VincentZ751/Drone_FC_project/Other_files/amongus.jpg

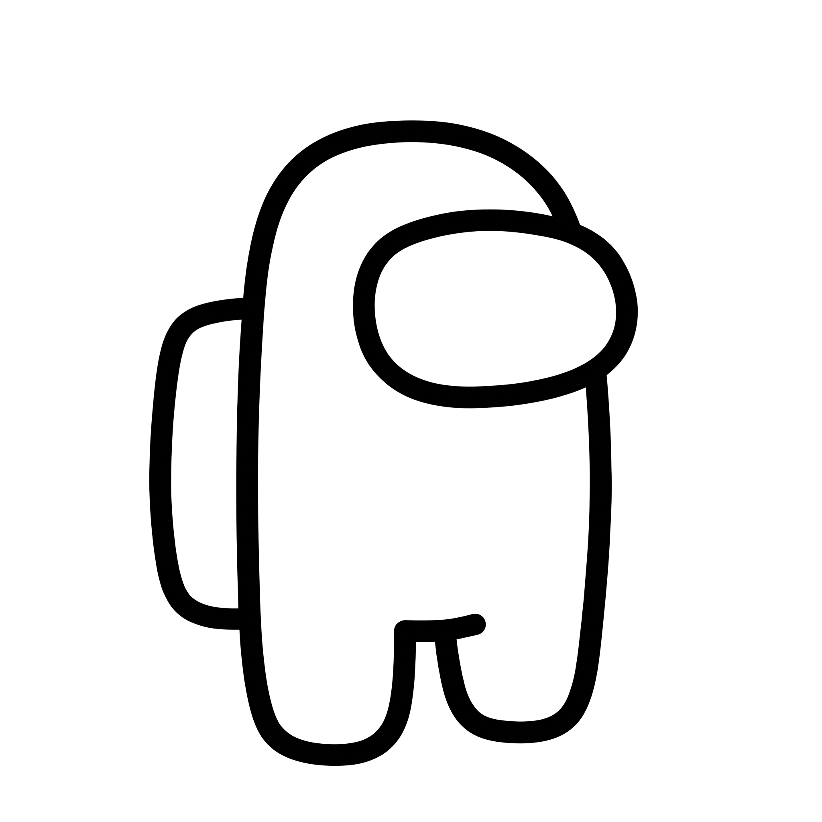
Other_files/amongus.jpg
