VincentZ751/Drone_FC_project/Other_files/finished_PCB.png

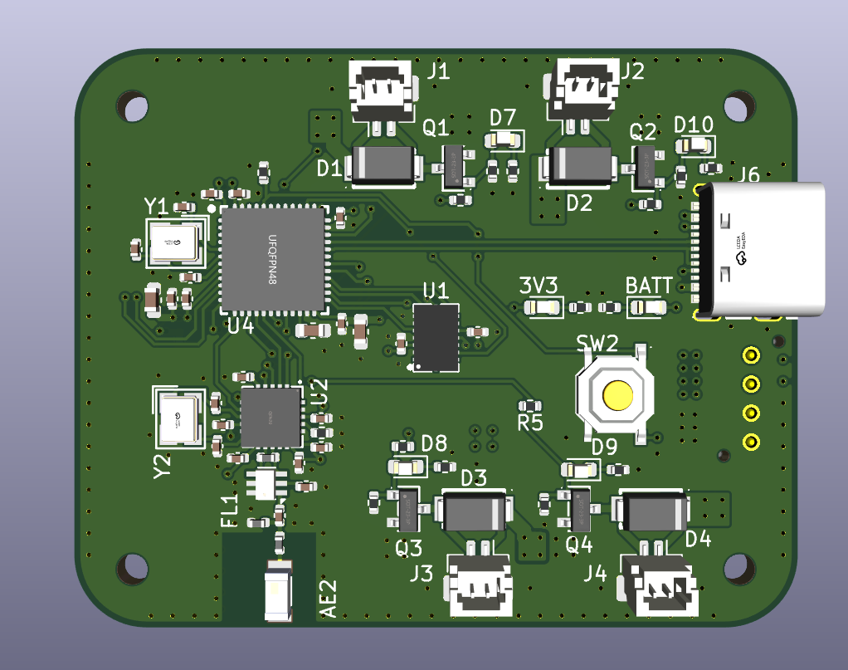
Other_files/finished_PCB.png
