VincentZ751/Drone_FC_project/Other_files/Gemini_Generated_Image_xpuy9sxpuy9sxpuy.jpg

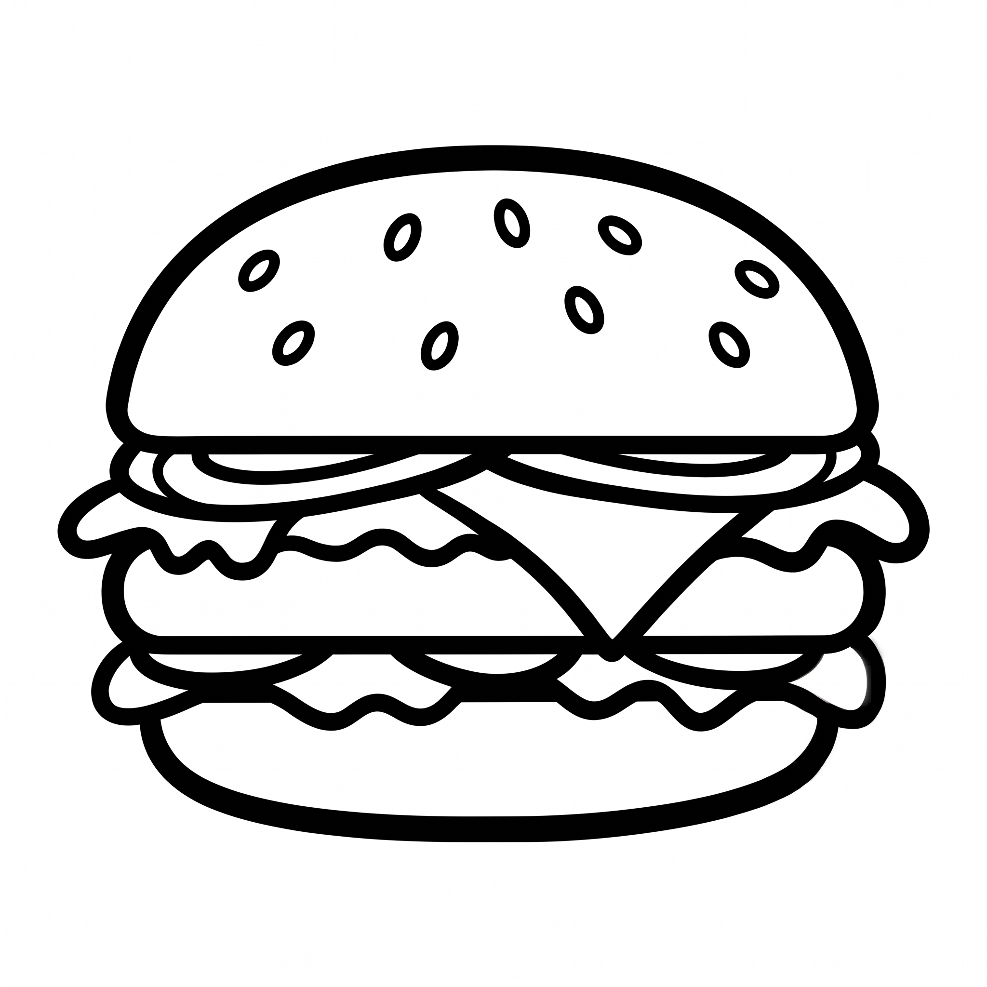
Other_files/Gemini_Generated_Image_xpuy9sxpuy9sxpuy.jpg
