VincentZ751/Drone_FC_project/Other_files/PCB_routing2.png

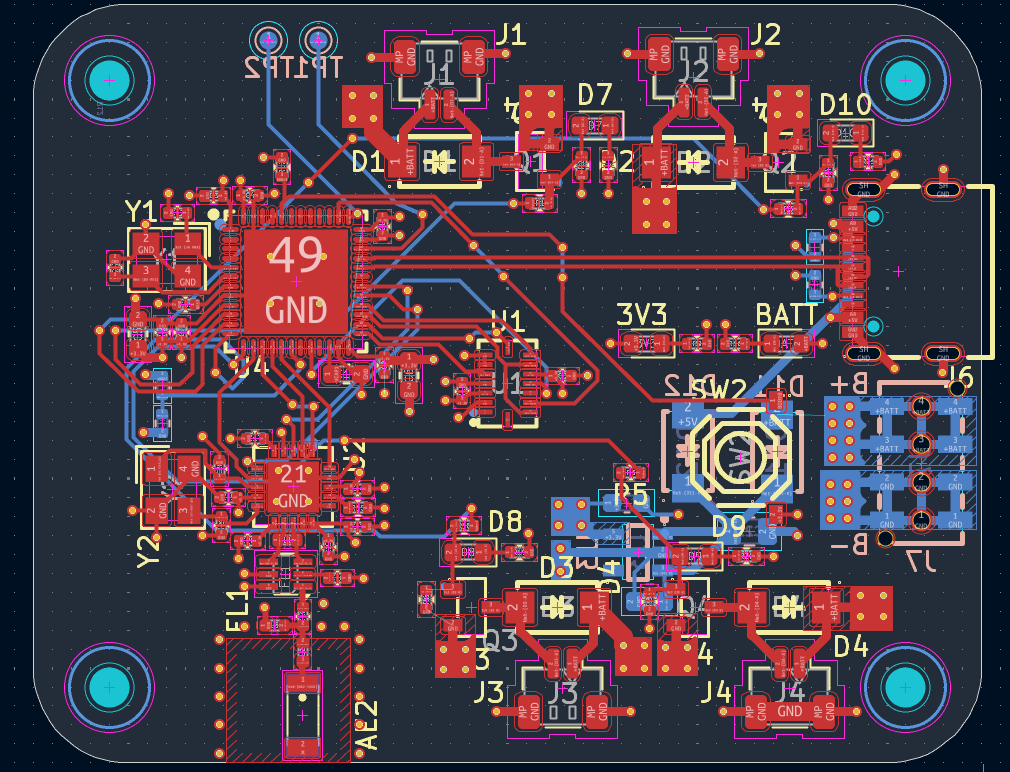
Other_files/PCB_routing2.png
