VincentZ751/Drone_FC_project/Other_files/pre-revert_PCB2.png

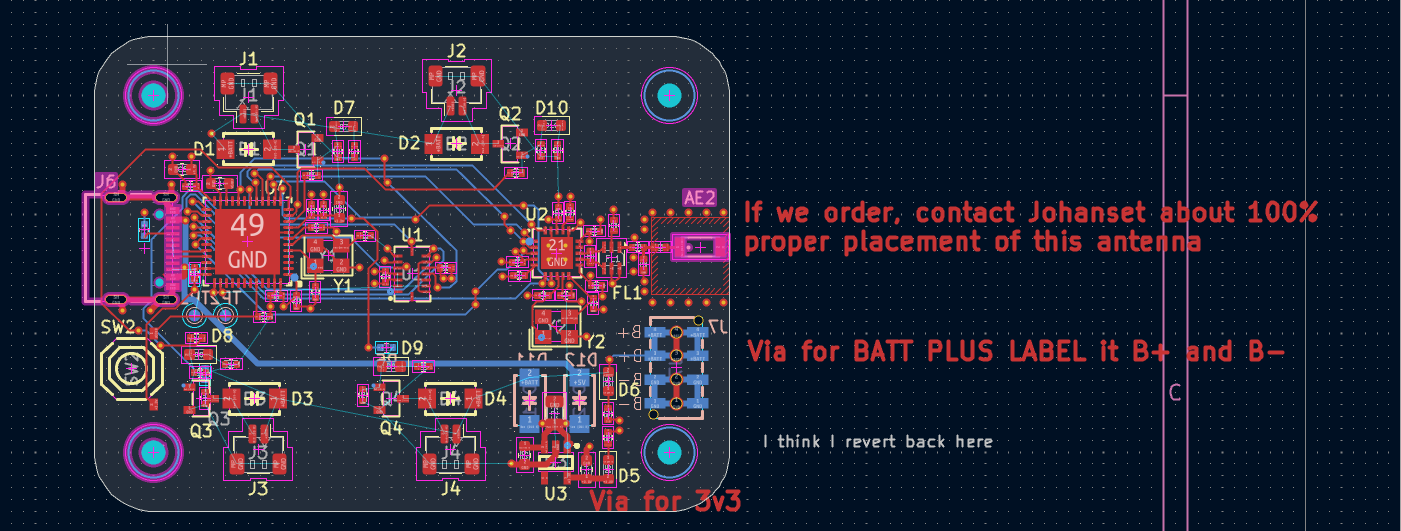
Other_files/pre-revert_PCB2.png
