VincentZ751/Drone_FC_project/Other_files/pre-revert_PCB.png

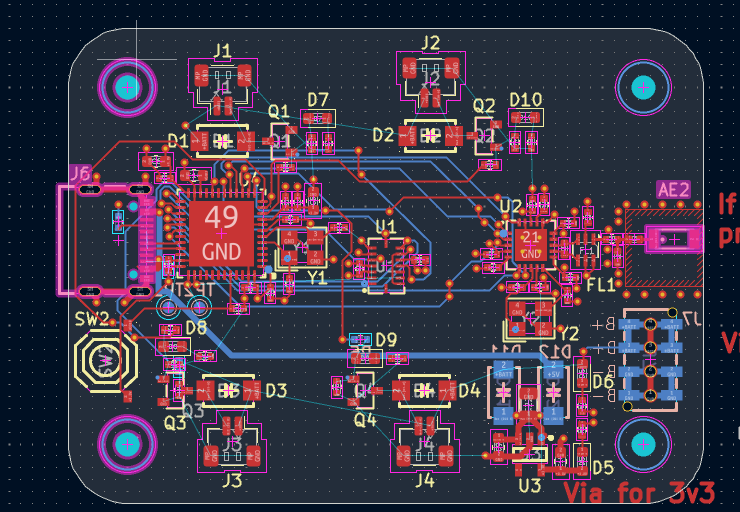
Other_files/pre-revert_PCB.png
