VincentZ751/Drone_FC_project/Other_files/schematic_image1.png

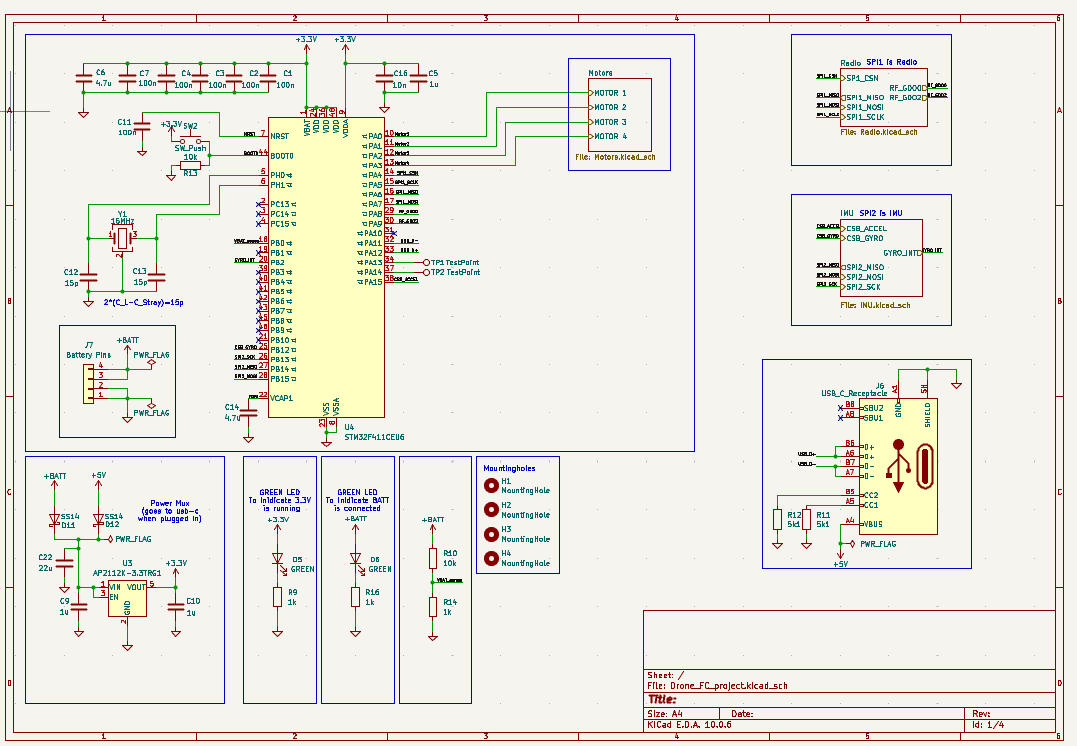
Other_files/schematic_image1.png
