VincentZ751/Drone_FC_project/Other_files/stm32_pinout_image.png

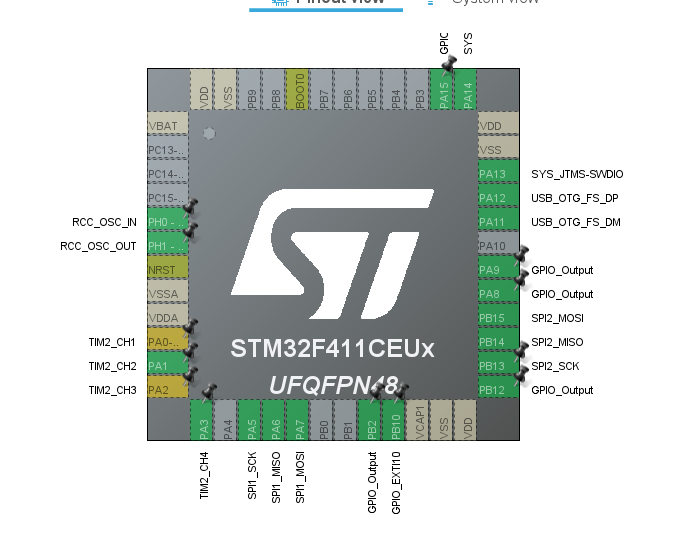
Other_files/stm32_pinout_image.png
