VincentZ751/Drone_FC_project/production/bom.csv

Designator | Footprint | Quantity | Value | LCSC Part #
3V3, BATT | 0603 | 2 | GREEN
AE2 | XDCR_2450AT18B100E | 1 | 2450AT18B100E
C1, C11, C15, C17, C2, C23, C24, C25, C26, C27, C3, C4, C7, C8 | 0402 | 14 | 100n
C10, C5, C9 | 0603 | 3 | 1u
C12, C13 | 0402 | 2 | 15p
C14, C6 | 0603 | 2 | 4.7u
C16, L1 | 0402 | 2 | 10n
C18 | 0402 | 1 | 22p
C19 | 0402 | 1 | 1p2
C20, C21 | 0402 | 2 | 27p
C22 | 0805 | 1 | 22u
D1, D11, D12, D2, D3, D4 | SS14 | 6 | SS14 | C2480
D10, D7, D8, D9 | 0603 | 4 | RED
FL1 | Balun_Johanson_0896BM15A0001 | 1 | 2450BM15B0003001E
J1, J2, J3, J4 | JST_SH_BM02B-SRSS-TB_1x02-1MP_P1.00mm_Vertical | 4 | Conn_01x02_MountingPin
J6 | USB_C_Receptacle_TYPE-C-31-M-12A | 1 | USB_C_Receptacle | C5337088
J7 | Battery_pin | 1 | Battery Pins | C39833032
L2 | 0402 | 1 | 3n3
L3 | 0402 | 1 | 2n7
Q1, Q2, Q3, Q4 | SOT-23-3_AO3400A | 4 | AO3400A | C20917
R1, R18, R3, R5 | 0402 | 4 | 47R
R10, R13, R2, R4, R6, R8 | 0402 | 6 | 10k
R11, R12 | 0402 | 2 | 5k1
R14, R16, R17, R19, R20, R21, R9 | 0402 | 7 | 1k
R15 | 0402 | 1 | 56k
SW2 | TS-1187A-B-A-B(SPST_button) | 1 | SW_Push | C318884
TP1, TP2 | TestPoint_Pad_D1.0mm | 2 | TestPoint
U1 | LGA-16_Bosch_BMI088 | 1 | BMI088 | C194919
U2 | QFN-20_CC2500RGPR | 1 | CC2500RGPR | C57494
U3 | SOT-23-5_AP2112K-3.3 | 1 | AP2112K-3.3TRG1 | C51118
U4 | UFQFPN-48_STM32F411CEU6 | 1 | STM32F411CEU6 | C60420
Y1 | Crystal_SMD_3225-4P(16_26MHz) | 1 | 16MHz | C70573
Y2 | Crystal_SMD_3225-4P(16_26MHz) | 1 | 26MHz | C70573
