VincentZ751/Drone_FC_project/other_parts/2450AT18B100E/2450AT18B100E.step

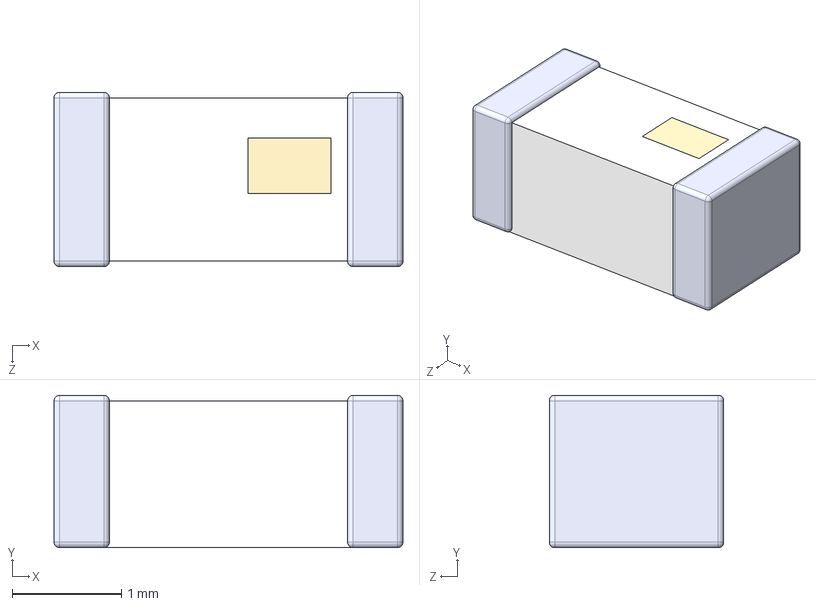
[picture p9: CAD file, 2026-10-24]
other_parts/2450AT18B100E/2450AT18B100E.step
3.20 x 1.40 x 1.60 mm
