VincentZ751/Drone_FC_project/Drone_FC_project.kicad_pcb

## KiCad design Drone_FC_project.kicad_pcb (2026-11-09)

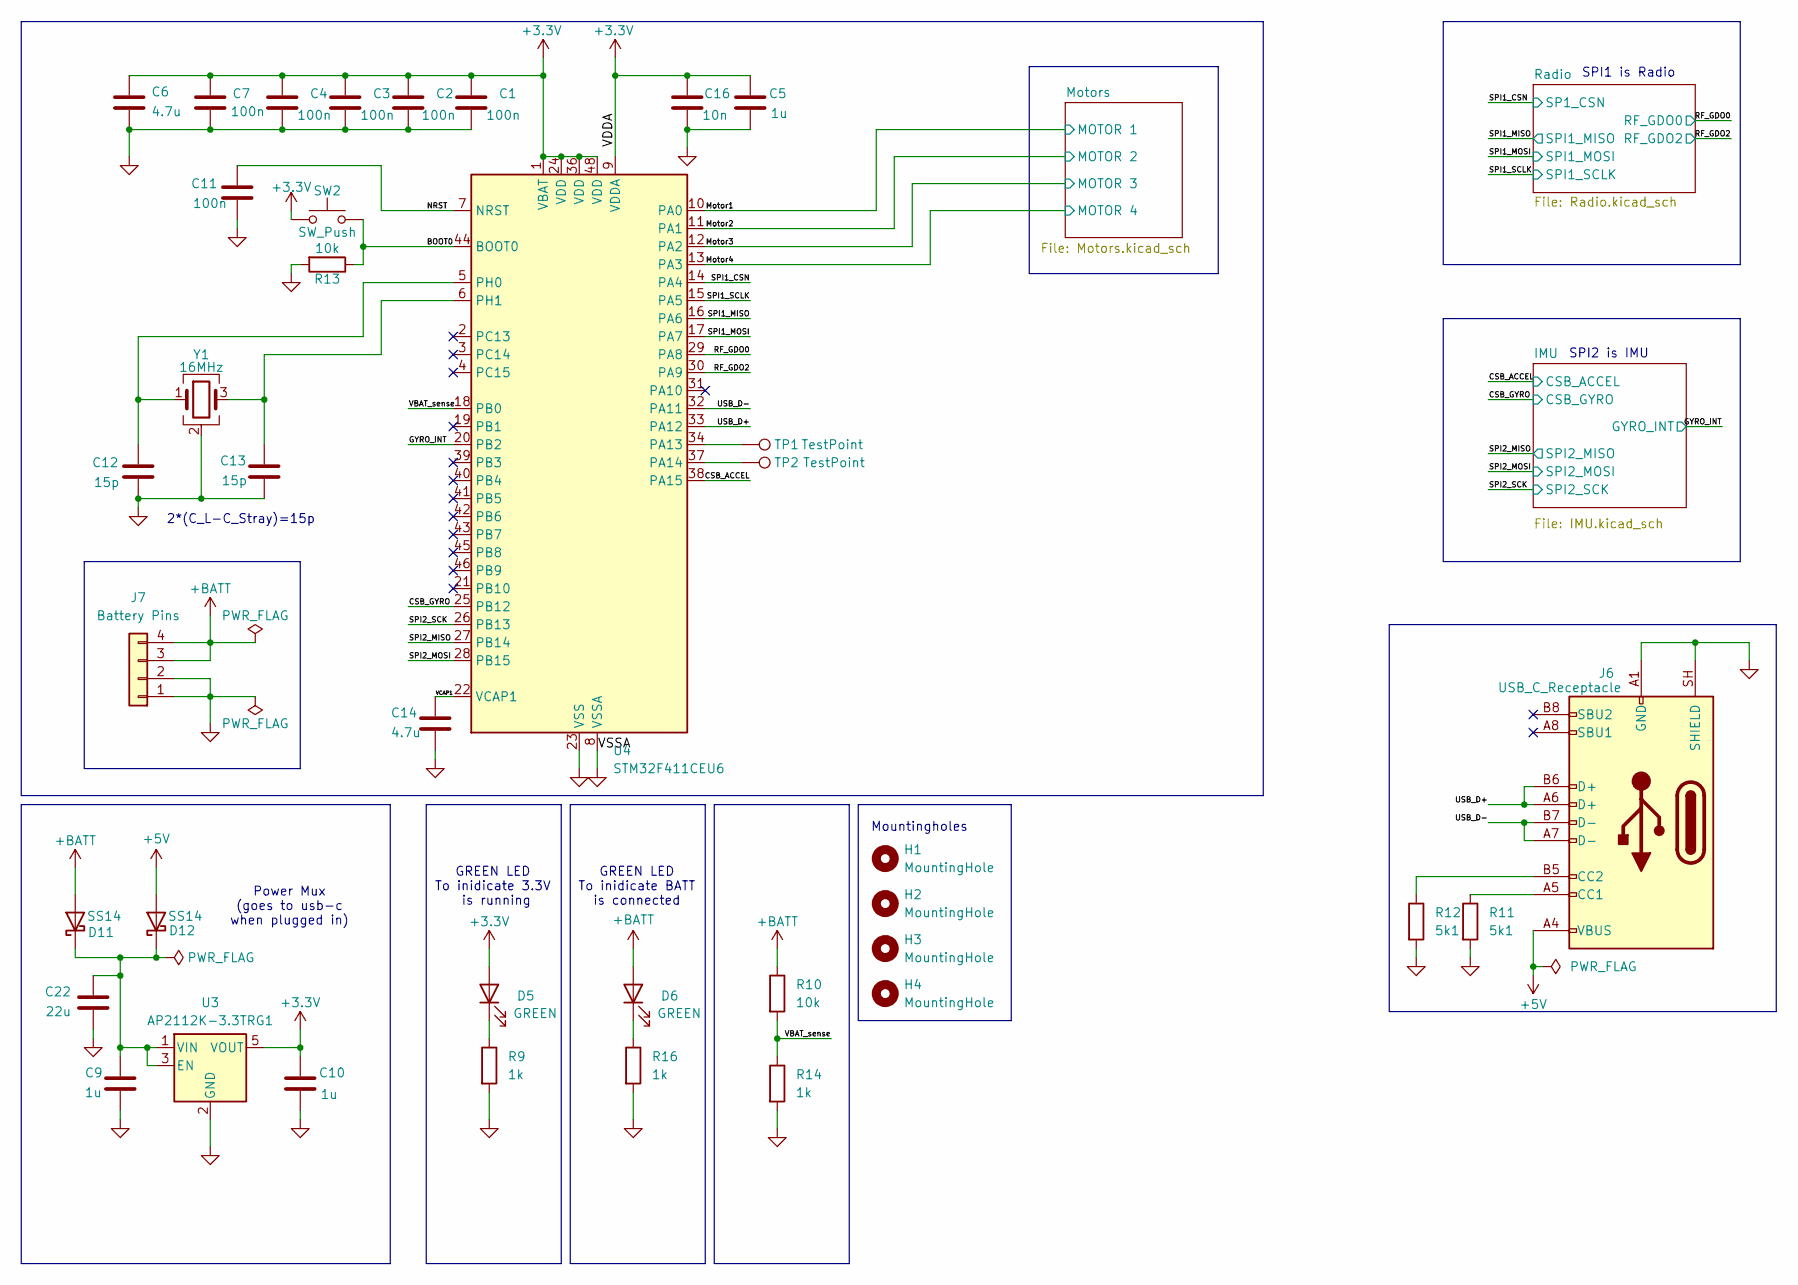
[picture p14: schematic Drone_FC_project.kicad_sch]

Parts:
C1, C2, C3, C4, C7, C11: 100n; C_0402_1005Metric
C5, C9, C10: 1u; C_0603_1608Metric
C6, C14: 4.7u; C_0603_1608Metric
C12, C13: 15p; C_0402_1005Metric
C16: 10n; C_0402_1005Metric
C22: 22u; C_0805_2012Metric
D5, D6: GREEN; LED_0603_1608Metric
D11, D12: SS14
H1, H2, H3, H4: MountingHole; MountingHole_2.1mm
J6: USB_C_Receptacle; USB_C_Receptacle_TYPE-C-31-M-12A
J7: Battery Pins; Battery_pin
R9, R14, R16: 1k; R_0402_1005Metric
R10, R13: 10k; R_0402_1005Metric
R11, R12: 5k1; R_0402_1005Metric
SW2: SW_Push; TS-1187A-B-A-B(SPST_button)
TP1, TP2: TestPoint; TestPoint_Pad_D1.0mm
U3: AP2112K-3.3TRG1; SOT-23-5_AP2112K-3.3
U4: STM32F411CEU6; UFQFPN-48_STM32F411CEU6
Y1: 16MHz; Crystal_SMD_3225-4P(16_26MHz)

Connections:
+3.3V: C1.1, C2.1, C3.1, C4.1, C5.1, C6.1, C7.1, C10.1, C16.1, D5.2 (A), SW2.2, U3.5 (VOUT), U4.1 (VBAT), U4.9 (VDDA), U4.24 (VDD), U4.36 (VDD), U4.48 (VDD); also elsewhere on the board
+5V: D12.2 (A), J6.A4 (VBUS), J6.A9 (VBUS), J6.B4 (VBUS), J6.B9 (VBUS)
+BATT: D6.2 (A), D11.2 (A), J7.3, J7.4, R10.1; also elsewhere on the board
/BOOT0: R13.1, SW2.1, U4.44 (BOOT0)
/CSB_ACCEL: U4.38 (PA15); also elsewhere on the board
/CSB_GYRO: U4.25 (PB12); also elsewhere on the board
/GYRO_INT: U4.20 (PB2); also elsewhere on the board
/Motor1: U4.10 (PA0); also elsewhere on the board
/Motor2: U4.11 (PA1); also elsewhere on the board
/Motor3: U4.12 (PA2); also elsewhere on the board
/Motor4: U4.13 (PA3); also elsewhere on the board
/NRST: C11.1, U4.7 (NRST)
/RF_GDO0: U4.29 (PA8); also elsewhere on the board
/RF_GDO2: U4.30 (PA9); also elsewhere on the board
/SPI1_CSN: U4.14 (PA4); also elsewhere on the board
/SPI1_MISO: U4.16 (PA6); also elsewhere on the board
/SPI1_MOSI: U4.17 (PA7); also elsewhere on the board
/SPI1_SCLK: U4.15 (PA5); also elsewhere on the board
/SPI2_MISO: U4.27 (PB14); also elsewhere on the board
/SPI2_MOSI: U4.28 (PB15); also elsewhere on the board
/SPI2_SCK: U4.26 (PB13); also elsewhere on the board
/USB_D+: J6.A6 (D+), J6.B6 (D+), U4.33 (PA12)
/USB_D-: J6.A7 (D-), J6.B7 (D-), U4.32 (PA11)
/VBAT_sense: R10.2, R14.1, U4.18 (PB0)
/VCAP1: C14.1, U4.22 (VCAP1)
GND: C1.2, C2.2, C3.2, C4.2, C5.2, C6.2, C7.2, C9.2, C10.2, C11.2, C12.2, C13.2, C14.2, C16.2, C22.2, J6.A1 (GND), J6.A12 (GND), J6.B1 (GND), J6.B12 (GND), J6.SH (SHIELD), J7.1, J7.2, R9.2, R11.2, R12.2, R13.2, R14.2, R16.2, U3.2 (GND), U4.8 (VSSA), U4.23 (VSS), U4.35 (VSS), U4.47 (VSS), U4.49 (VSS), Y1.2 (G), Y1.4 (G); also elsewhere on the board
unnamed 32: D5.1 (K), R9.1; also elsewhere on the board
unnamed 33: D6.1 (K), R16.1; also elsewhere on the board
unnamed: C9.1, C22.1, D11.1 (K), D12.1 (K), U3.1 (VIN), U3.3 (EN)
unnamed: J6.A5 (CC1), R11.1
unnamed: J6.B5 (CC2), R12.1
unnamed: TP1.1 (1_1), U4.34 (PA13)
unnamed: TP2.1 (1_1), U4.37 (PA14)
unnamed: C12.1, U4.5 (PH0), Y1.1
unnamed: C13.1, U4.6 (PH1), Y1.3

Notes on the sheet:
Power Mux (goes to usb-c when plugged in)
SPI2 is IMU
GREEN LED To inidicate 3.3V is running
Mountingholes
GREEN LED To inidicate BATT is connected
SPI1 is Radio
2*(C_L-C_Stray)=15p

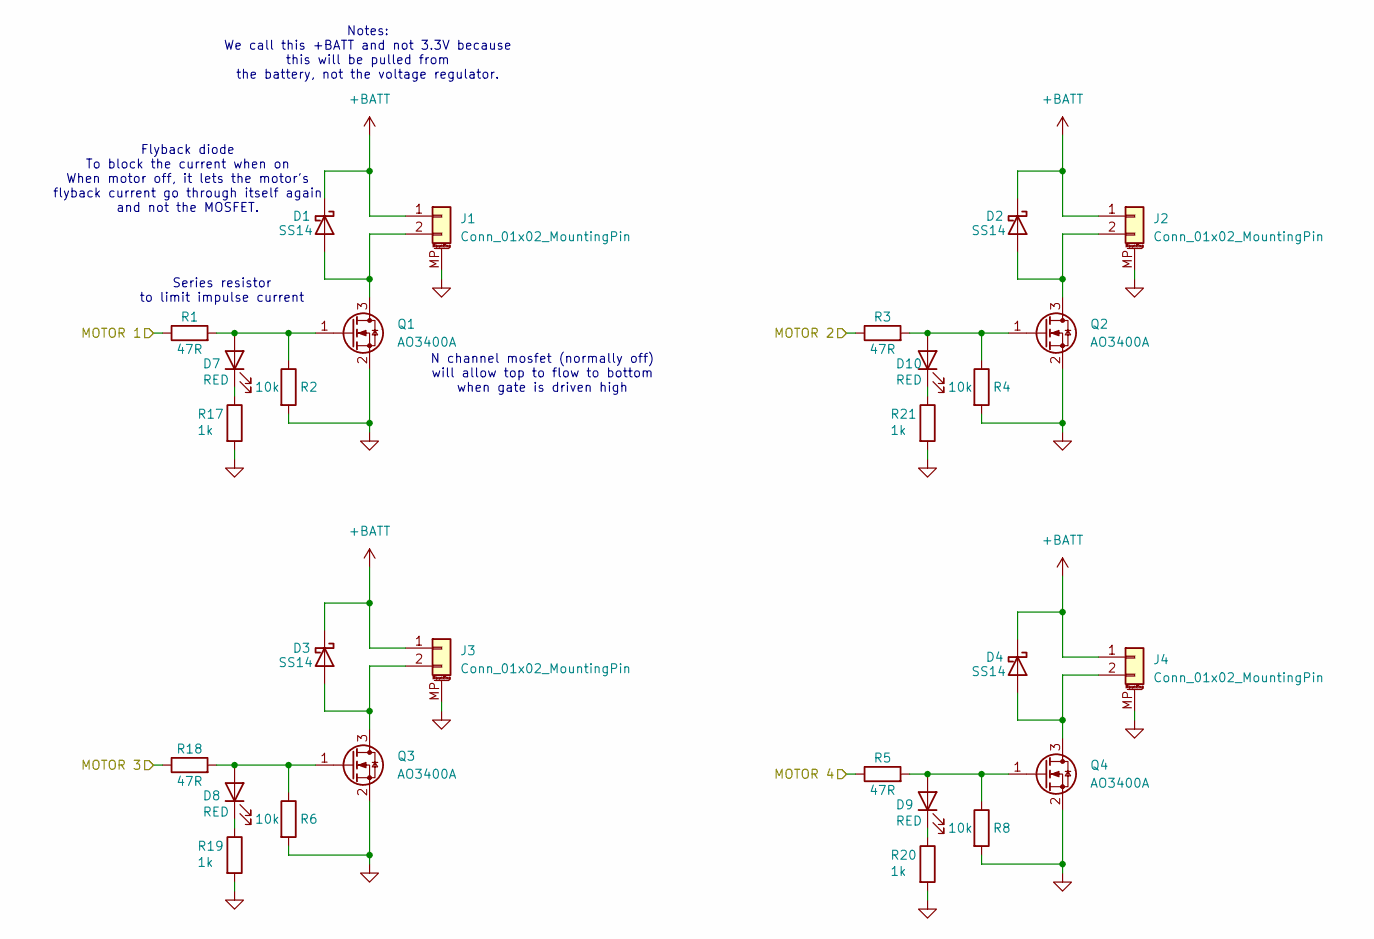
[picture p15: schematic Motors.kicad_sch, Motor Schematic]

Parts:
D1, D2, D3, D4: SS14
D7, D8, D9, D10: RED; LED_0603_1608Metric
J1, J2, J3, J4: Conn_01x02_MountingPin; JST_SH_BM02B-SRSS-TB_1x02-1MP_P1.00mm_Vertical
Q1, Q2, Q3, Q4: AO3400A; SOT-23-3_AO3400A
R1, R3, R5, R18: 47R; R_0402_1005Metric
R2, R4, R6, R8: 10k; R_0402_1005Metric
R17, R19, R20, R21: 1k; R_0402_1005Metric

Connections:
+BATT: D1.1 (K), D2.1 (K), D3.1 (K), D4.1 (K), J1.1, J2.1, J3.1, J4.1; also elsewhere on the board
/Motor1: R1.1; also elsewhere on the board
/Motor2: R3.1; also elsewhere on the board
/Motor3: R18.1; also elsewhere on the board
/Motor4: R5.1; also elsewhere on the board
GND: J1.MP (MountPin), J2.MP (MountPin), J3.MP (MountPin), J4.MP (MountPin), Q1.2 (S), Q2.2 (S), Q3.2 (S), Q4.2 (S), R2.2, R4.2, R6.2, R8.2, R17.2, R19.2, R20.2, R21.2; also elsewhere on the board
unnamed: D1.2 (A), J1.2, Q1.3 (D)
unnamed: D2.2 (A), J2.2, Q2.3 (D)
unnamed: D3.2 (A), J3.2, Q3.3 (D)
unnamed: D4.2 (A), J4.2, Q4.3 (D)
unnamed: D7.2 (A), Q1.1 (G), R1.2, R2.1
unnamed: D7.1 (K), R17.1
unnamed: D8.2 (A), Q3.1 (G), R6.1, R18.2
unnamed: D8.1 (K), R19.1
unnamed: D9.2 (A), Q4.1 (G), R5.2, R8.1
unnamed: D9.1 (K), R20.1
unnamed: D10.2 (A), Q2.1 (G), R3.2, R4.1
unnamed: D10.1 (K), R21.1

Notes on the sheet:
Series resistor to limit impulse current
Notes: We call this +BATT and not 3.3V because this will be pulled from the battery, not the voltage regulator.
Flyback diode To block the current when on When motor off, it lets the motor's flyback current go through itself again and not the MOSFET.
N channel mosfet (normally off) will allow top to flow to bottom when gate is driven high

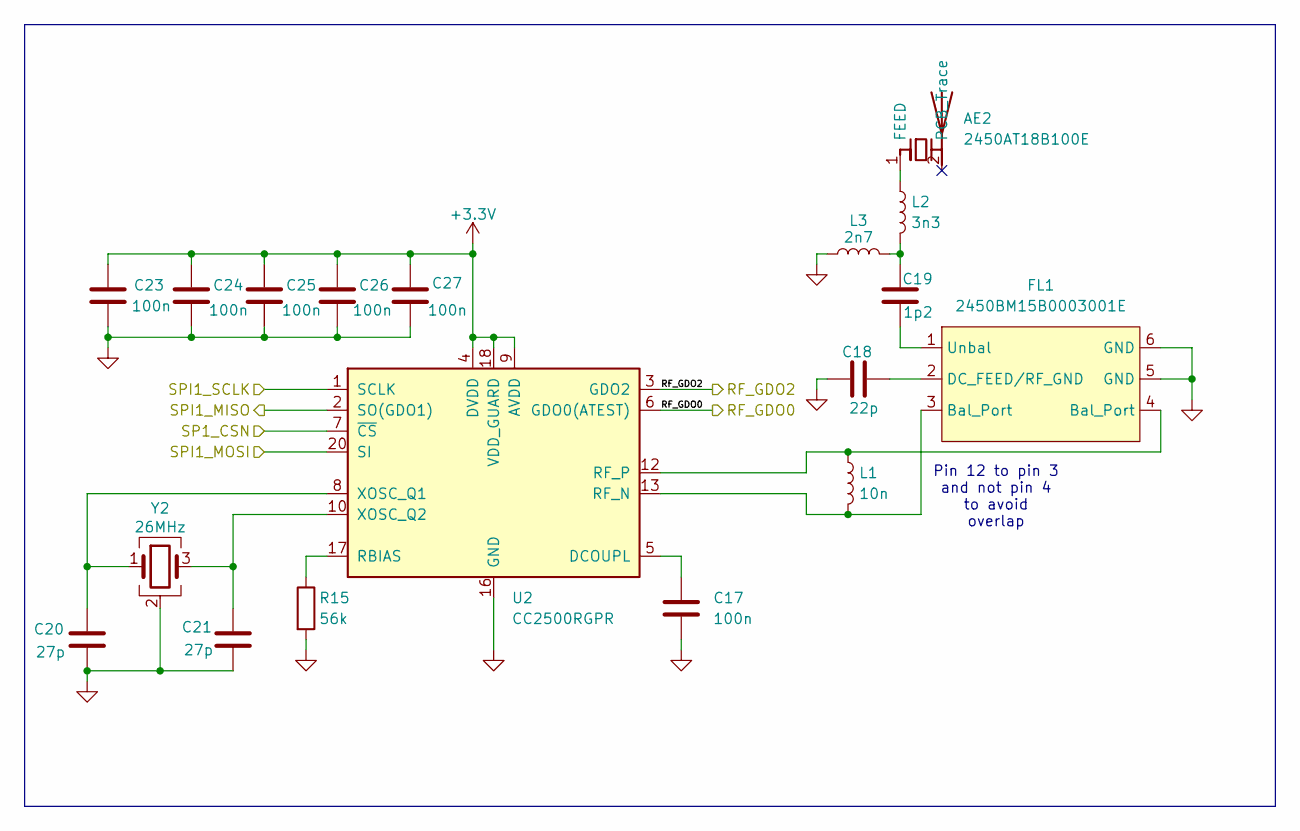
[picture p16: schematic Radio.kicad_sch]

Parts:
AE2: 2450AT18B100E; XDCR_2450AT18B100E
C17, C23, C24, C25, C26, C27: 100n; C_0402_1005Metric
C18: 22p; C_0402_1005Metric
C19: 1p2; C_0402_1005Metric
C20, C21: 27p; C_0402_1005Metric
FL1: 2450BM15B0003001E; Balun_Johanson_0896BM15A0001
L1: 10n; L_0402_1005Metric
L2: 3n3; L_0402_1005Metric
L3: 2n7; L_0402_1005Metric
R15: 56k; R_0402_1005Metric
U2: CC2500RGPR; QFN-20_CC2500RGPR
Y2: 26MHz; Crystal_SMD_3225-4P(16_26MHz)

Connections:
+3.3V: C23.1, C24.1, C25.1, C26.1, C27.1, U2.4 (DVDD), U2.9 (AVDD), U2.11 (AVDD), U2.14 (AVDD), U2.15 (AVDD), U2.18 (VDD_GUARD); also elsewhere on the board
/RF_GDO0: U2.6 (GDO0(ATEST)); also elsewhere on the board
/RF_GDO2: U2.3 (GDO2); also elsewhere on the board
/SPI1_CSN: U2.7 (~CS); also elsewhere on the board
/SPI1_MISO: U2.2 (SO(GDO1)); also elsewhere on the board
/SPI1_MOSI: U2.20 (SI); also elsewhere on the board
/SPI1_SCLK: U2.1 (SCLK); also elsewhere on the board
GND: C17.2, C18.1, C20.2, C21.2, C23.2, C24.2, C25.2, C26.2, C27.2, FL1.5 (GND), FL1.6 (GND), L3.1, R15.2, U2.16 (GND), U2.19 (GND), U2.21 (GND), Y2.2 (G), Y2.4 (G); also elsewhere on the board
unnamed: AE2.1 (FEED_1), L2.1
unnamed: C19.2, L2.2, L3.2
unnamed: C18.2, FL1.2 (DC_FEED/RF_GND)
unnamed: C19.1, FL1.1 (Unbal)
unnamed: C17.1, U2.5 (DCOUPL)
unnamed: R15.1, U2.17 (RBIAS)
unnamed: FL1.3 (Bal_Port), L1.2, U2.13 (RF_N)
unnamed: FL1.4 (Bal_Port), L1.1, U2.12 (RF_P)
unnamed: C20.1, U2.8 (XOSC_Q1), Y2.1
unnamed: C21.1, U2.10 (XOSC_Q2), Y2.3

Notes on the sheet:
Pin 12 to pin 3 and not pin 4 to avoid overlap

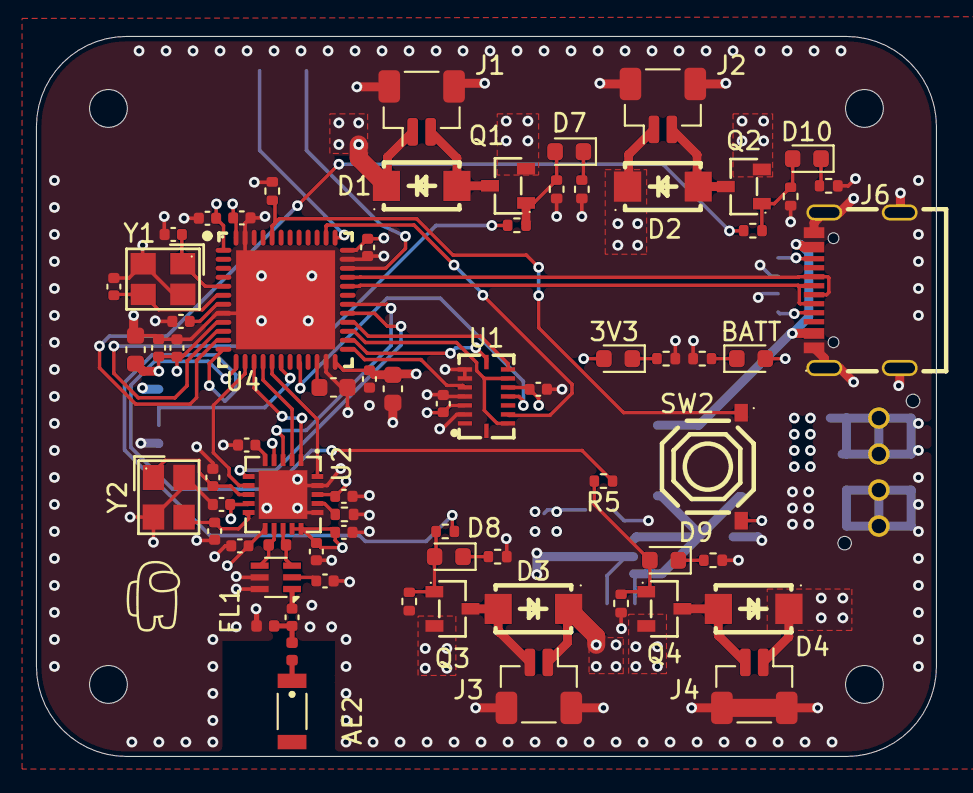
[picture p17: board Drone_FC_project.kicad_pcb from above]

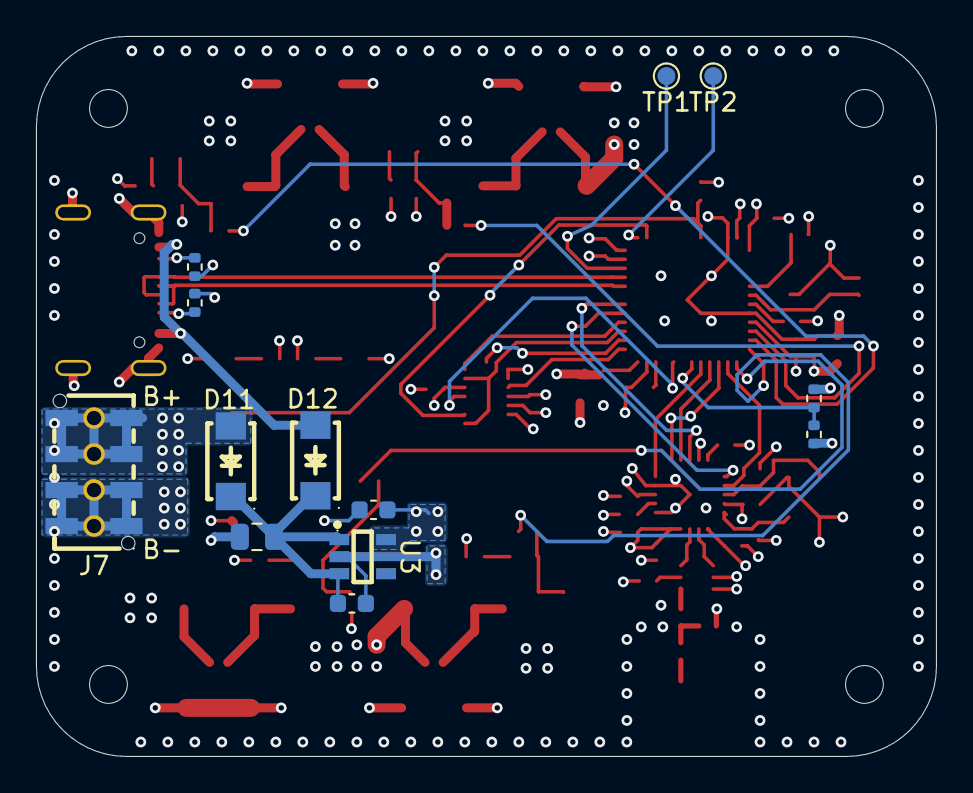
[picture p18: board Drone_FC_project.kicad_pcb from below]

Board: 4 copper layers, 50.0 x 40.0 mm, 87 parts (13 on the bottom side), 57 nets.

Other parts of the board:
3V3: GREEN; LED_0603_1608Metric
BATT: GREEN; LED_0603_1608Metric
C8, C15: 100n; C_0402_1005Metric
U1: BMI088; LGA-16_Bosch_BMI088

Their connections:
+3.3V: 3V3.2 (A), C8.1, C15.1, U1.3 (VDD), U1.11 (VDDIO); also elsewhere on the board
+BATT: BATT.2 (A); also elsewhere on the board
/CSB_ACCEL: U1.14 (~CSB1); also elsewhere on the board
/CSB_GYRO: U1.5 (~CSB2); also elsewhere on the board
/GYRO_INT: U1.12 (INT3); also elsewhere on the board
/SPI2_MISO: U1.10 (SDO2), U1.15 (SDO1); also elsewhere on the board
/SPI2_MOSI: U1.9 (SDI/SDA); also elsewhere on the board
/SPI2_SCK: U1.8 (SCK/SCL); also elsewhere on the board
GND: C8.2, C15.2, U1.2 (GNDA), U1.4 (GNDA), U1.6 (GNDIO), U1.7 (PS); also elsewhere on the board
unnamed 32: 3V3.1 (K); also elsewhere on the board
unnamed 33: BATT.1 (K); also elsewhere on the board
