VincentZ751/Drone_FC_project/(commit log)

2026-10-07 Initial commit!!!
    [Drone_FC_project.kicad_pcb, Drone_FC_project.kicad_sch]
2026-10-07 test updates
    [Drone_FC_project.kicad_sch]
2026-10-10 m hole
    [Drone_FC_project.kicad_sch]
2026-10-10 created four sublevel schematics (battery, motors, IMU, radio)
    [Battery_and_regulator.kicad_sch, Drone_FC_project.kicad_sch, Motors.kicad_sch, imu.kicad_sch]
2026-10-10 filled in the four MOSFETS for motor control
    [Battery_and_regulator.kicad_sch, Drone_FC_project.kicad_sch, Motors.kicad_sch, Radio.kicad_sch, imu.kicad_sch]
2026-10-10 Finished motor and battery/regulator subfolders
    Also made a folder for holding datasheets.
    [Battery_and_regulator.kicad_sch, Drone_FC_project.kicad_sch, Motors.kicad_sch, Radio.kicad_sch]
2026-10-10 small update
    I misclicked earlier
    [Battery_and_regulator.kicad_sch, Drone_FC_project.kicad_sch, Motors.kicad_sch, Radio.kicad_sch]
2026-10-15 updated pin to accurate size
    [Motors.kicad_sch]
2026-10-20 Updated stm32
    Updated stm32 and usb-c
    [Battery_and_regulator.kicad_sch, Drone_FC_project.kicad_sch, imu.kicad_sch]
2026-10-23 IMU, VBAT_Sense,
    Fixed some decoupling issues, made the IMU into SPI mode. Wired all to stm32. Few updates on the appearances as well to make it look more organized.
    [Drone_FC_project.kicad_sch, Motors.kicad_sch, imu.kicad_sch]
2026-10-23 radio starting
    Radio start + changes to the root name
    [Drone_FC_project.kicad_sch, Motors.kicad_sch, Radio.kicad_sch, imu.kicad_sch, remote.kicad_sch]
2026-10-24 Created radio, cleanup a few other things
    Finished radio schematic, added datasheets, added a stm32cubemx file for pinouts, added SPI1 and SPI2.
    [2450AT18B100E.step, Drone_FC_project.kicad_sch, Radio.kicad_sch, imu.kicad_sch]
2026-10-24 Fixing some radio things
    [Drone_FC_project.kicad_sch, Radio.kicad_sch, imu.kicad_sch]
2026-10-28 Motor and UBS 5V update
    Motors each have a RED LED to indicate their on status.
    5V on USB now runs when and only when the USB is plugged in. It will ignore battery otherwise. Green Led's indicate if the power is running.
    [Drone_FC_project.kicad_sch, Motors.kicad_sch]
2026-10-29 footprints and spacing
    Added half the footprints and made thigns look nicer.
    [Drone_FC_project.kicad_sch, Motors.kicad_sch, Radio.kicad_sch, imu.kicad_sch]
2026-10-30 more footprint work and downloaded some
    [Drone_FC_project.kicad_sch, Motors.kicad_sch, Radio.kicad_sch, imu.kicad_sch, remote.kicad_sch]
2026-11-01 Started layout
    [Drone_FC_project.kicad_pcb, Drone_FC_project.kicad_sch, Radio.kicad_sch]
2026-11-02 Finished footprint placement
    Made some pours as well
    [Drone_FC_project.kicad_pcb, Drone_FC_project.kicad_sch]
2026-11-04 Fixed a DRC warnings
    Ready to start routing now!
    [Drone_FC_project.kicad_pcb]
2026-11-05 Started routing
    Routing almost done, needs vias to connect the power planes
    [Drone_FC_project.kicad_pcb, Drone_FC_project.kicad_sch]
2026-11-07 Messy tracing, needs to revert
    Save here but gonna revert now
    [Drone_FC_project.kicad_pcb]
2026-11-07 Reverted PCB routing back to clean state
    [Drone_FC_project.kicad_pcb]
2026-11-07 Finsihed routing, needs review and DRC
    [Drone_FC_project.kicad_pcb]
2026-11-08 Cleaned up DRC errors
    Should be done now!
    [Drone_FC_project.kicad_pcb, Drone_FC_project.kicad_sch]
2026-11-09 Added bitmap image and gerbers
    About 8$ for the chip, 50$ for the components and 40$ for assemnbly.
    [Drone_FC_project.kicad_pcb, bom.csv, designators.csv, positions.csv]
